sui001/switching-ceramic-extruder-controller/README.md

# ProjectAAA
Project Art! Art! Art!

read from nrf24l01 and an ardio uno. parse to another arduino to control the switching between 3 different extruders.
