sui001/switching-ceramic-extruder-controller/PCB/BOM_Board1_PCB1_2024-04-18.xlsx

No. | Quantity | Device | Designator | Footprint | Value | Manufacturer Part | Manufacturer | Supplier Part | Supplier | LCSC Price | LCSC Stock | LCSC Part Name
1 | 3 | DB128L-5.08-4P-GN-S | CN1,CN2,CN3 | CONN-TH_4P_DB128L-5.08-4P-GN-S |  | DB128L-5.08-4P-GN-S | DORABO(地博电气) | C2827883 | LCSC | 2.3268 | 2117 | 5.08mm 1x4P 排数:1 每排P数:4 直插
2 | 1 | NCD1206W1 | LED1 | LED-SMD_L3.2-W1.5-RD |  | NCD1206W1(WHITE) | 国星光电 | C130718 | LCSC | 0.273803 | 5073 | NCD1206W1
3 | 1 | NCD1206B1 | LED2 | LED1206-RD |  | NCD1206B1(BLUE) | 国星光电 | C130717 | LCSC | 0.216949 | 3757 | NCD1206B1
4 | 1 | NCD1206G1 | LED3 | LED1206-RD |  | NCD1206G1(GREEN) | 国星光电 | C99881 | LCSC | 0.195373 | 3178 | NCD1206G1
5 | 1 | NCD1206Y1 | LED4 | LED1206-RD |  | NCD1206Y1(YELLOW) | 国星光电 | C93094 | LCSC | 0.200342 | 3062 | NCD1206Y1
6 | 1 | NCD1206R1 | LED5 | LED1206-R-RD_RED |  | NCD1206R1(RED) | 国星光电 | C84270 | LCSC | 0.132452 | 18686 | NCD1206R1
7 | 1 | 2.54-1*6P母 | P1 | HDR-TH_6P-P2.54-V-F |  | Micro SD Card Reader | BOOMELE(博穆精密) | C40877 | LCSC | 0.46844 | 1217 | 间距:2.54mm 1x6P 直插
8 | 1 | 2.54-1*6P母 | P2 | HDR-TH_6P-P2.54-V-F |  | nRF24L01 | BOOMELE(博穆精密) | C40877 | LCSC | 0.46844 | 1217 | 间距:2.54mm 1x6P 直插
9 | 1 | 2.54-1*2P母 | P3 | HDR-TH_2P-P2.54-V-F |  | nRF24L01 | BOOMELE(博穆精密) | C49661 | LCSC | 0.234 | 4211 | 间距:2.54mm 1x2P 直插
10 | 5 | 1206W4F3300T5E | R1,R2,R3,R4,R5 | R1206 | 330Ω | 1206W4F3300T5E | UNI-ROYAL(厚声) | C17930 | LCSC | 0.018821 | 2186 | 330Ω ±1% 250mW 厚膜电阻
11 | 2 | 1206W4F1003T5E | R6,R7 | R1206 | 100kΩ | 1206W4F1003T5E | UNI-ROYAL(厚声) | C17900 | LCSC | 0.019788 | 6406 | 100kΩ ±1% 250mW 厚膜电阻
12 | 2 | TS-1109S-C-J | SW1,SW2 | SW-SMD_4P-L4.5-W4.5-P3.00-LS7.0 |  | TS-1109S-C-J | XKB Connectivity(中国星坤) | C318907 | LCSC | 0.209986 | 1219 | 4.5*4.5*8mm 立贴 轻触开关
13 | 3 | SS-12D10L5 | SW3,SW4,SW5 | SW-TH_SS-12D10L5 |  | SS-12D10L5 | XKB Connectivity(中国星坤) | C319012 | LCSC | 1.8981 | 8255 | 柄长5mm 直插双档 滑动开关
14 | 1 | PM254-1-04-Z-8.5_C2897367 | U3 | HDR-TH_4P-P2.54-V-F |  | OLED Display | HCTL(华灿天禄) | C2897367 | LCSC | 0.531437 | 1345 | 1x4P 间距:2.54mm 直插
15 | 1 | RK09D1130C3C | U4 | RES-TH_RK09D1130C2P | 10kΩ | RK09D1130C3C | ALPSALPINE(阿尔卑斯阿尔派) | C470316 | LCSC | 5.38 | 954 | 10kΩ ±20%
