sui001/switching-ceramic-extruder-controller/PCB/Order/jlcpcb_invoice.pdf

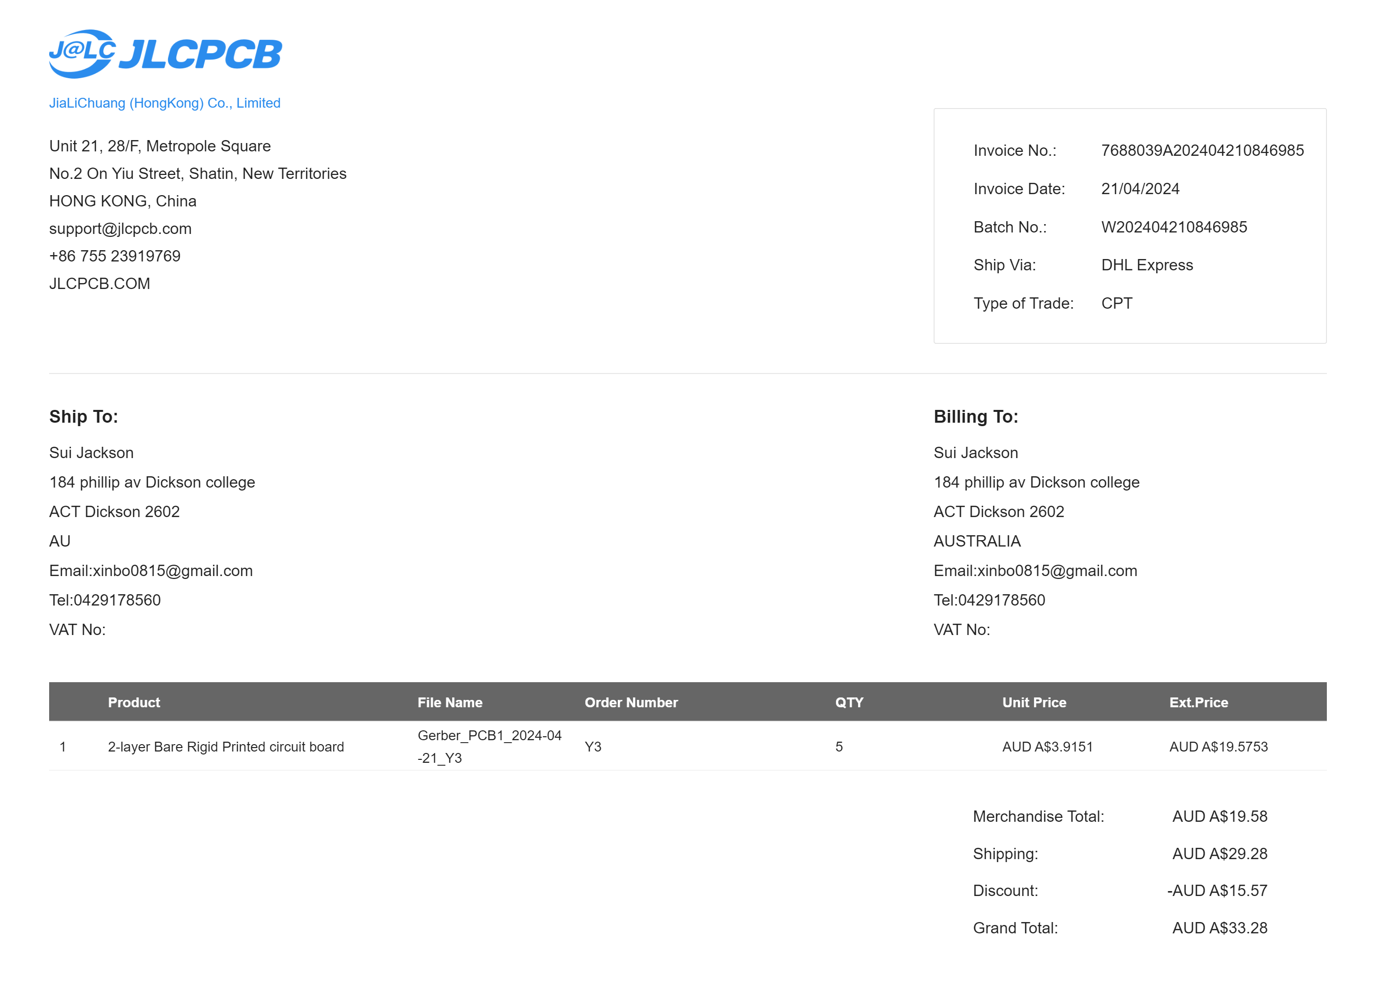
[picture p1: figure]
