sui001/switching-ceramic-extruder-controller/New Connection Map.pdf

# updated pin map for datk logging

□IE | Pinout ⑯ Antenaa | … GND

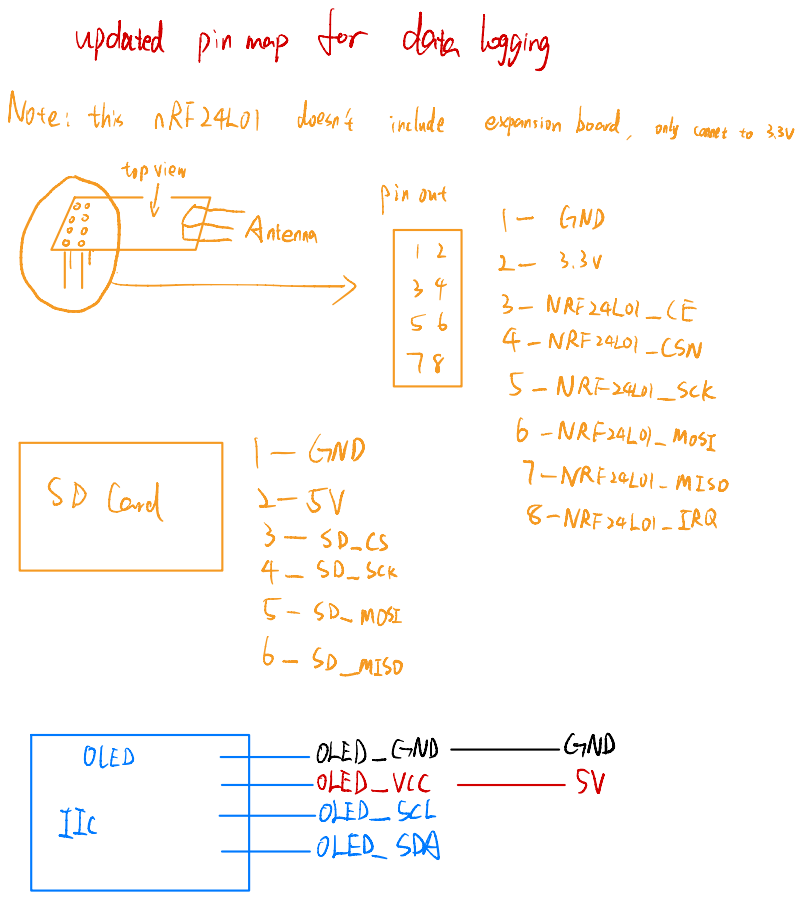
[picture p2: page 1]
Note :; this MRF 24Lol; doesnt include; expansion board ,; only connet to 3,; NRE 24L0I -; NRF 24L01 -; CSN; NRF24LO 1 -; Sck; GND; NRE24L⁰) _; MOSI; NRFEELOI _; MISO Spand; NRFZ4 LO1 -; 系RQ; SD_ MISO; OLEB; OLED -; GNB; OLED_; VCC; SCL; OLEB-; SDA

## Arduino® UNO R4 WiFi

# Mechanical Information

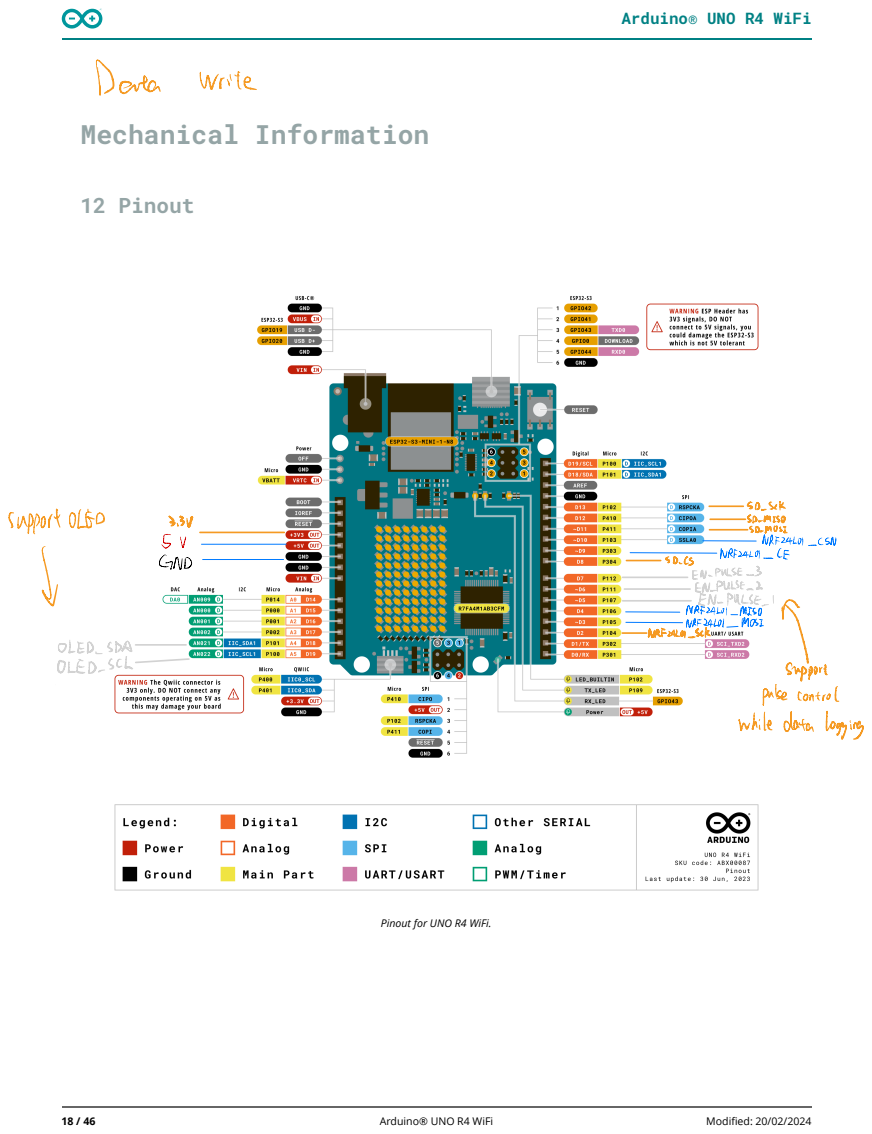
[picture p3: page 2]
Arduino® UNO R4 WiFi; Modified: 20/02/2024; 12 Pinout; Devla write; Sck; M号O; SUpPort OLED; SDIMOSI; NRF 24LO1 -; CSN; GND; ARFI4LO1 -; BULSE -; PULSE-; BULSE_; NREE4Lol; mIso; NRE24LO1 -; sck; OLED、; SBA; RRFI4LOl; MOSI; OLED-; SCh; support

Bulse control
while data logging

Pinout for UNO R4 WiFi.

## Arduino® UNO R4 WiFi

# Mechanical Information

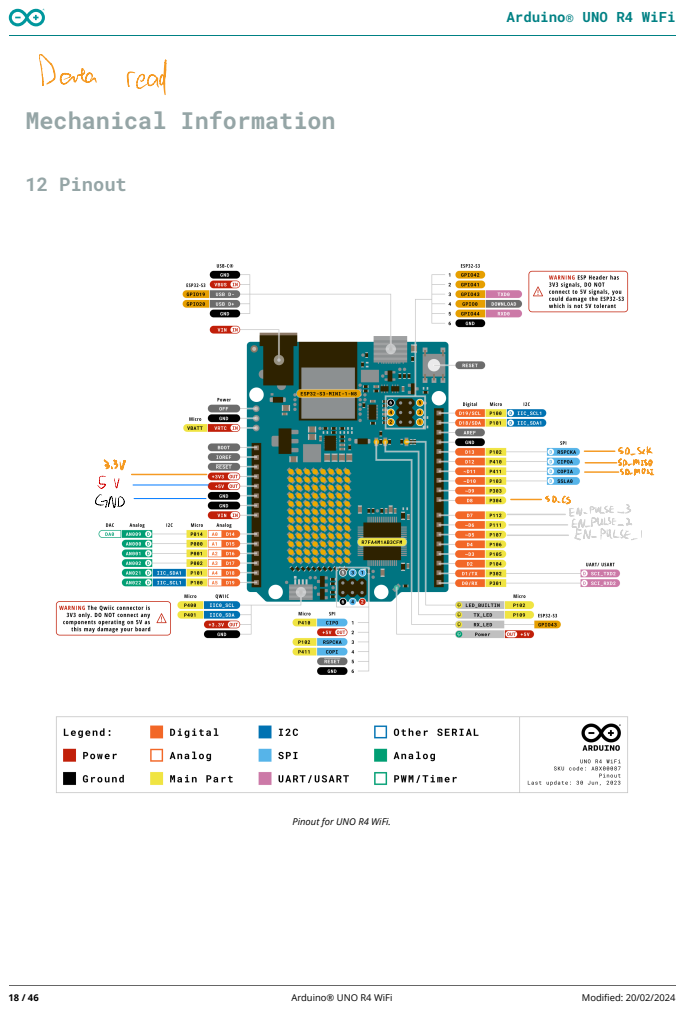
[picture p4: page 3]
Arduino® UNO R4 WiFi; Modified: 20/02/2024; 12 Pinout; Deala read; Sck; M号O; SBMOsI; GND; BULSE -; PULSE-; BULSE_

Pinout for UNO R4 WiFi.

updated | pin map for | palse | override
!m

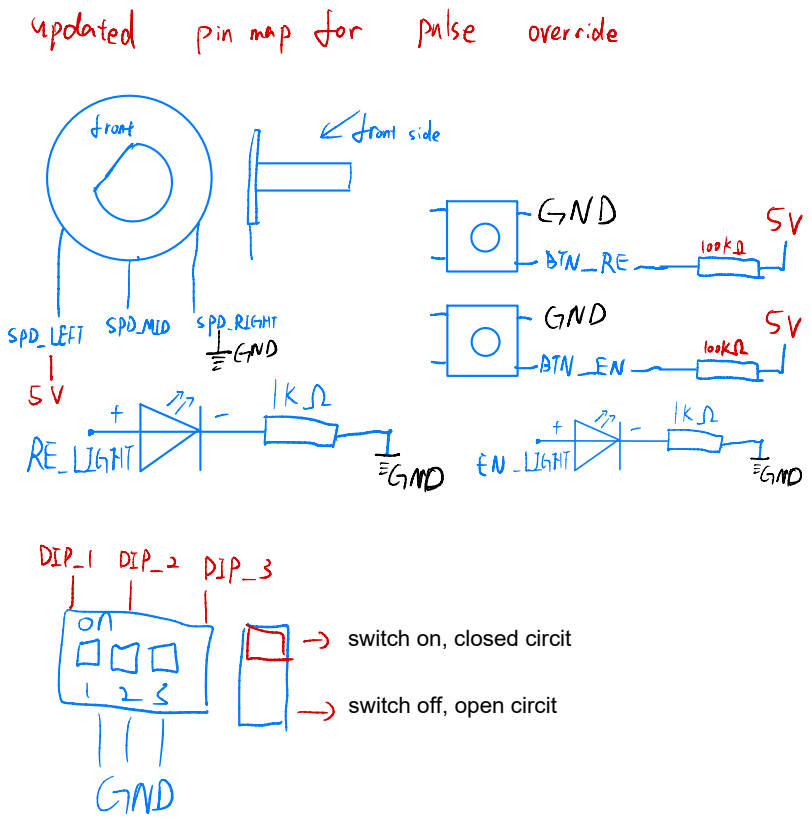
[picture p5: page 4]
GNDTOIMF; sookr 一; BTN_; SPD.; LEFT SBB-; MIB; SPB-; RIGHT; GND TO.uF 一; 言GND; BTN _; LIGHT; LIGET; 营Gx; DIP-; DIP_; PIP-; 四敏OO; switch on, closed circit

switch off, open circit

# Step motor driver control

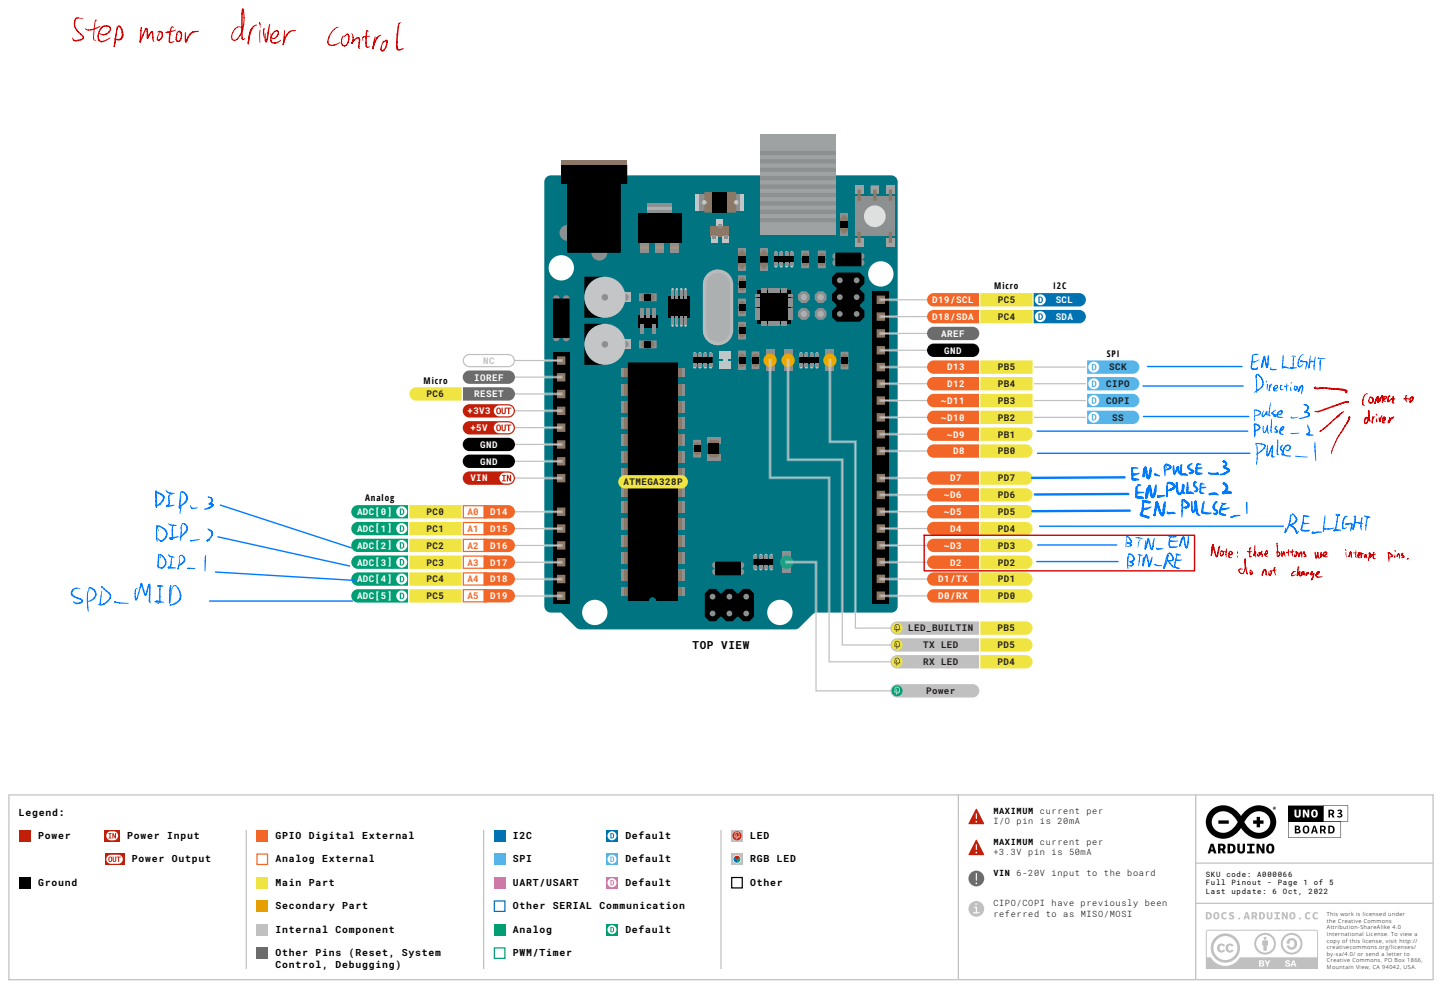
[picture p6: page 5]

PC2 | A2
PC3 | A3

MAXIMUM current per I/O pin is 20mA MAXIMUM current per +3.3V pin is 50mA VIN 6-20V input to the board CIPO/COPI have previously been referred to as MISO/MOSI

GPIO Digital External
Analog External
Main Part
Secondary Part
Internal Component
Other Pins (Reset, System
Control, Debugging)

SKU code: A000066 Full Pinout - Page 1 of 5 Last update: 6 Oct, 2022

This work is licensed under the Creative Commons Attribution-ShareAlike 4.0 International License. To view a

copy of this license, visit http://creativecommons.org/licenses/by-sa/4.0/ or send a letter to Creative Commons, PO Box 1866, Mountain View, CA 94042, USA.

## use case 1 :

µµ、

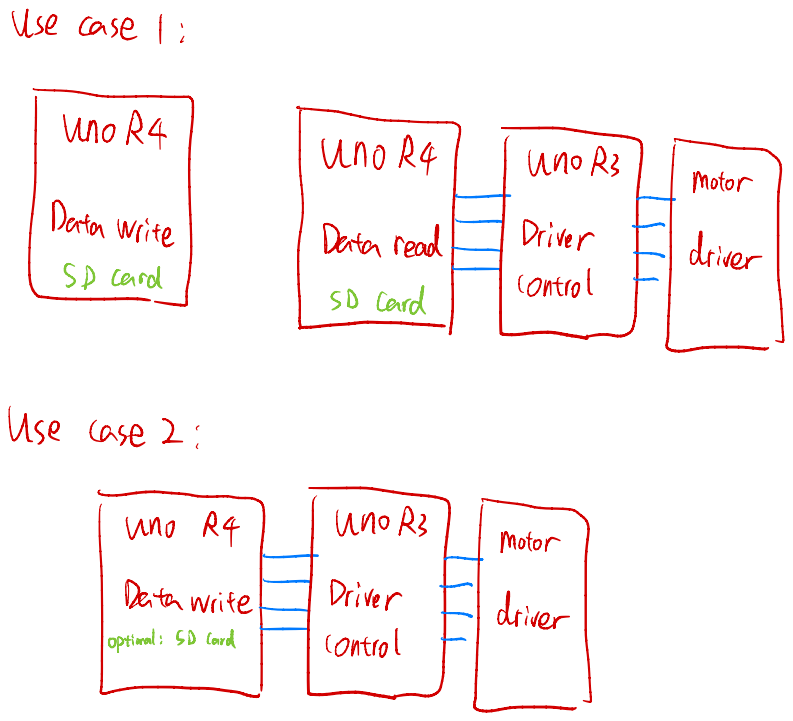
[picture p7: page 6]
Use case 2 : µµ
