sui001/switching-ceramic-extruder-controller/PCB/PCB_PCB1_2024-04-18.pdf

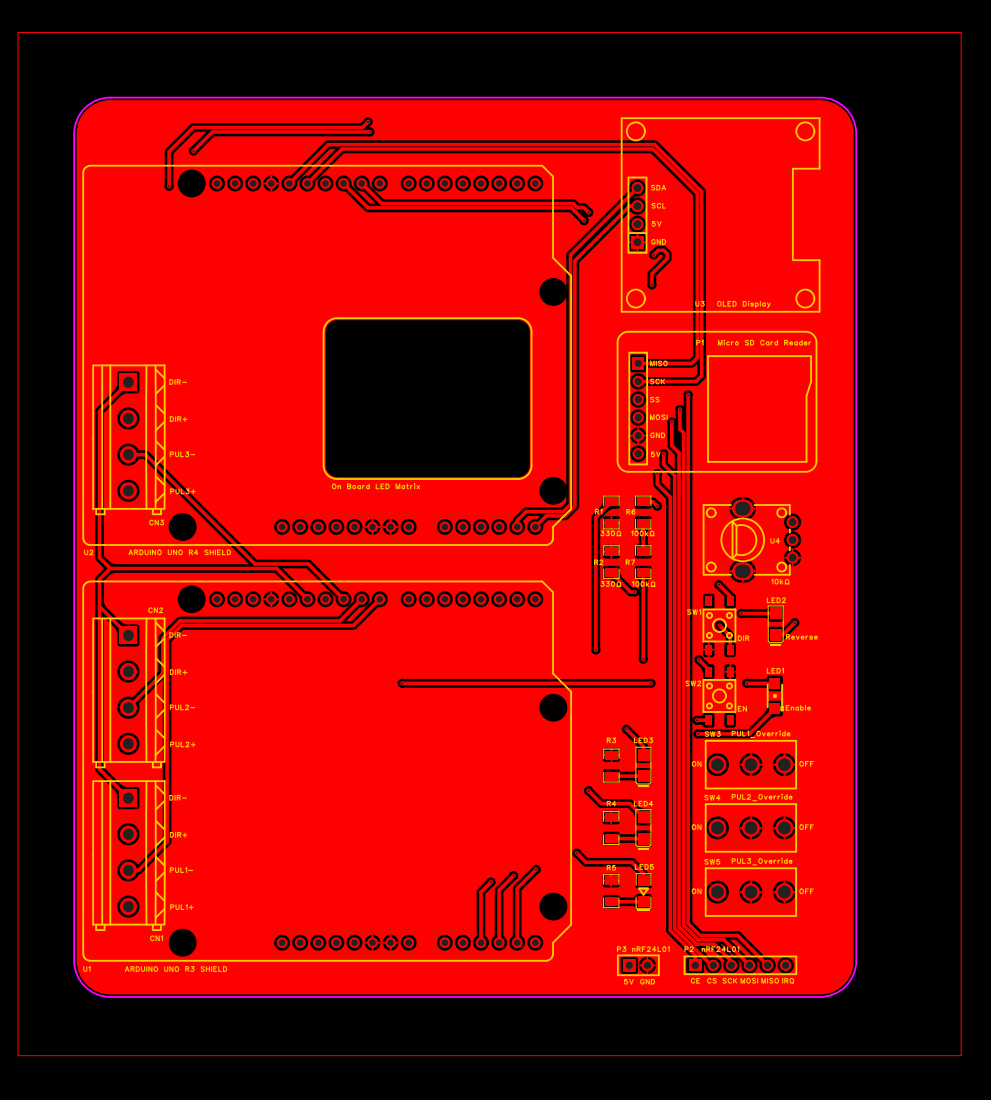
[picture p8: page 1]

On Board LED Matrix

5VGND CECSSCKMOSIMSOIRQ U1 ARDUINO UNO R3 SHIELD

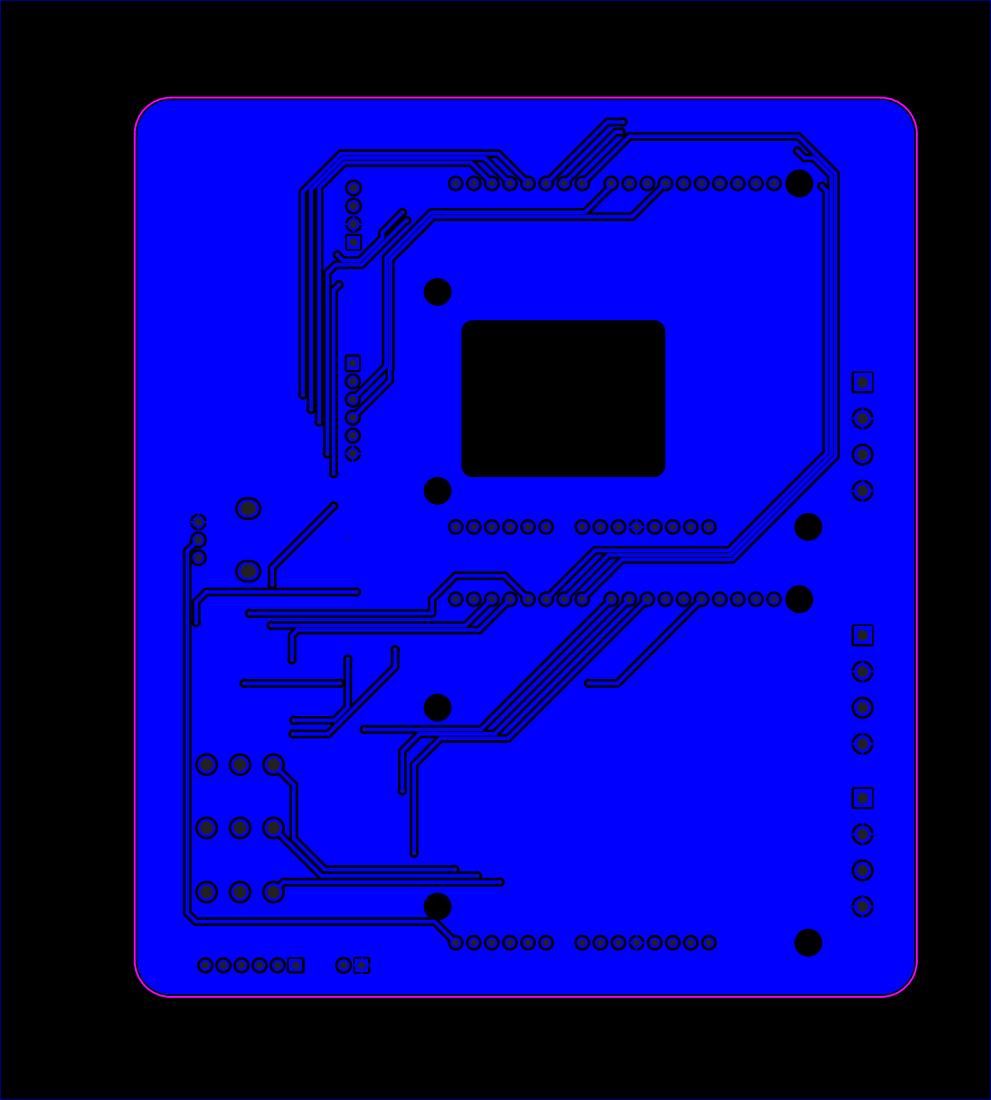
[picture p9: page 2]

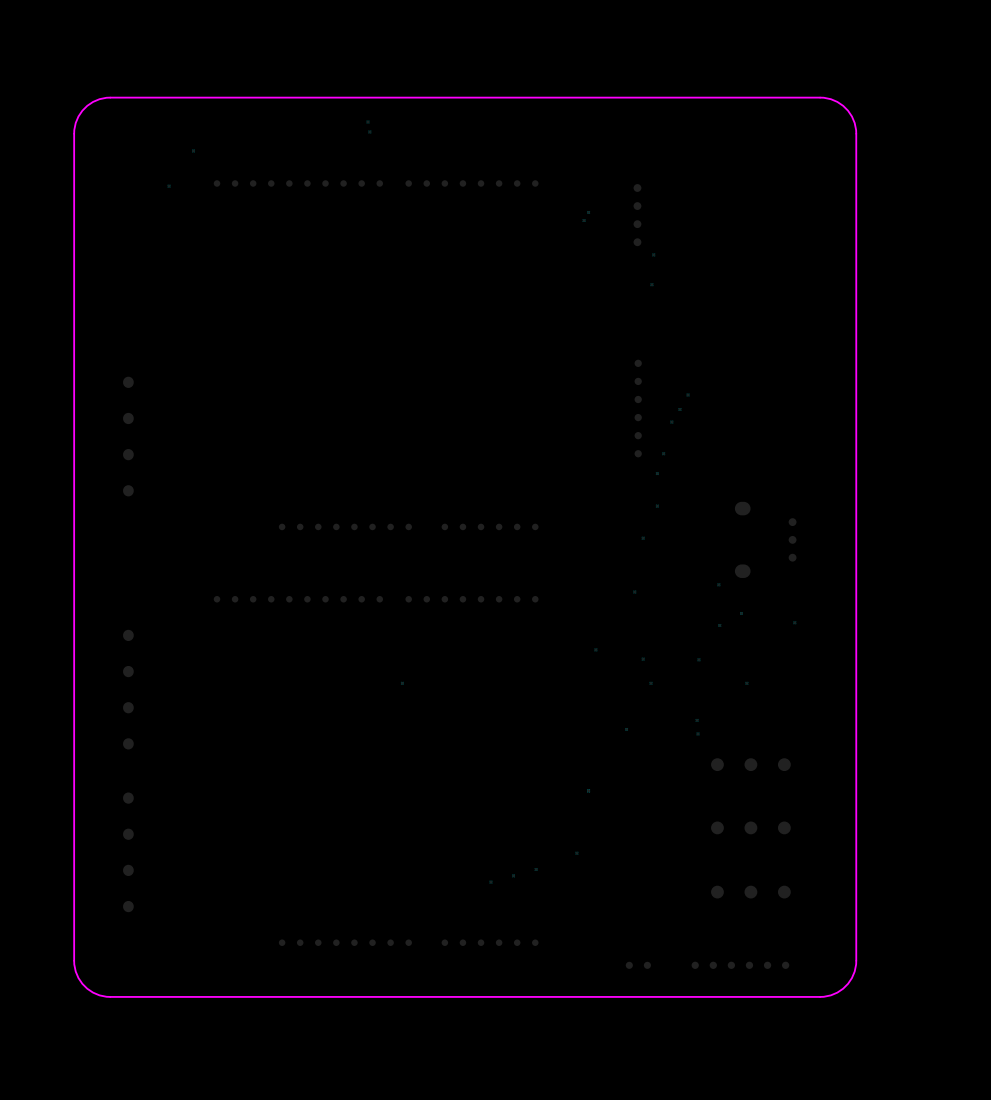
[picture p10: page 3]
