sui001/switching-ceramic-extruder-controller/PCB/SCH_Schematic1_2024-04-18.pdf

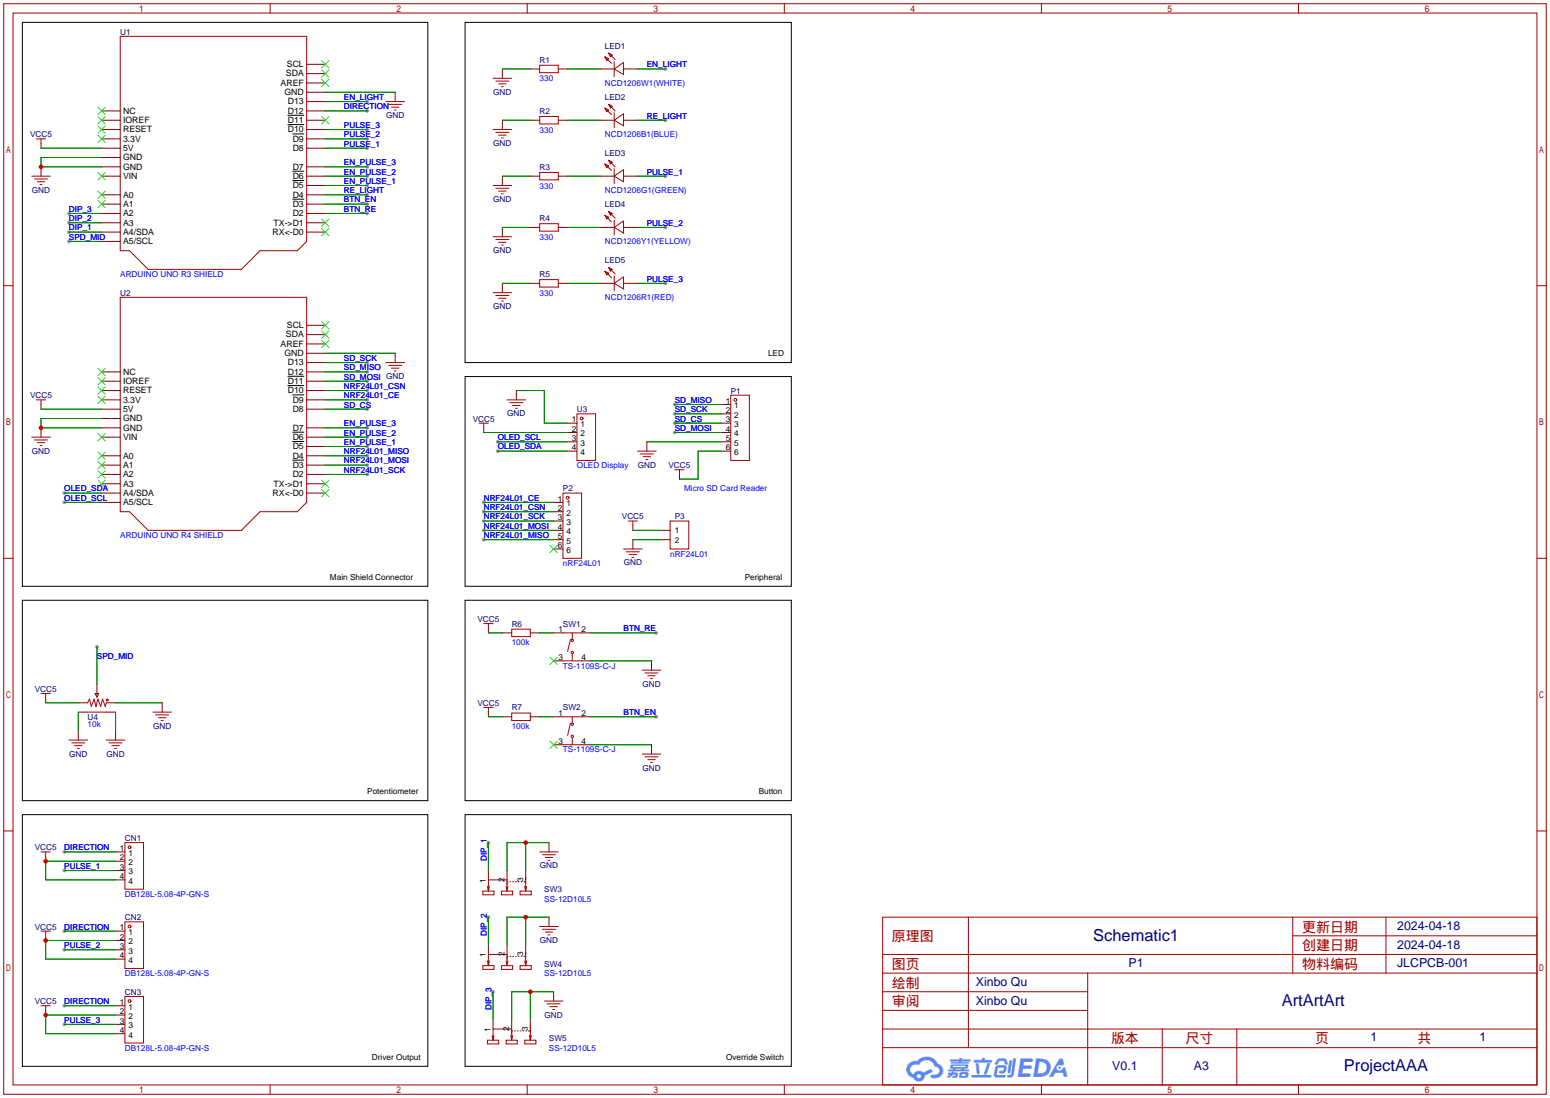
[picture p11: page 1]

Micro SD Card Reader
