sui001/switching-ceramic-extruder-controller/PCB/Order/lcsc.pdf

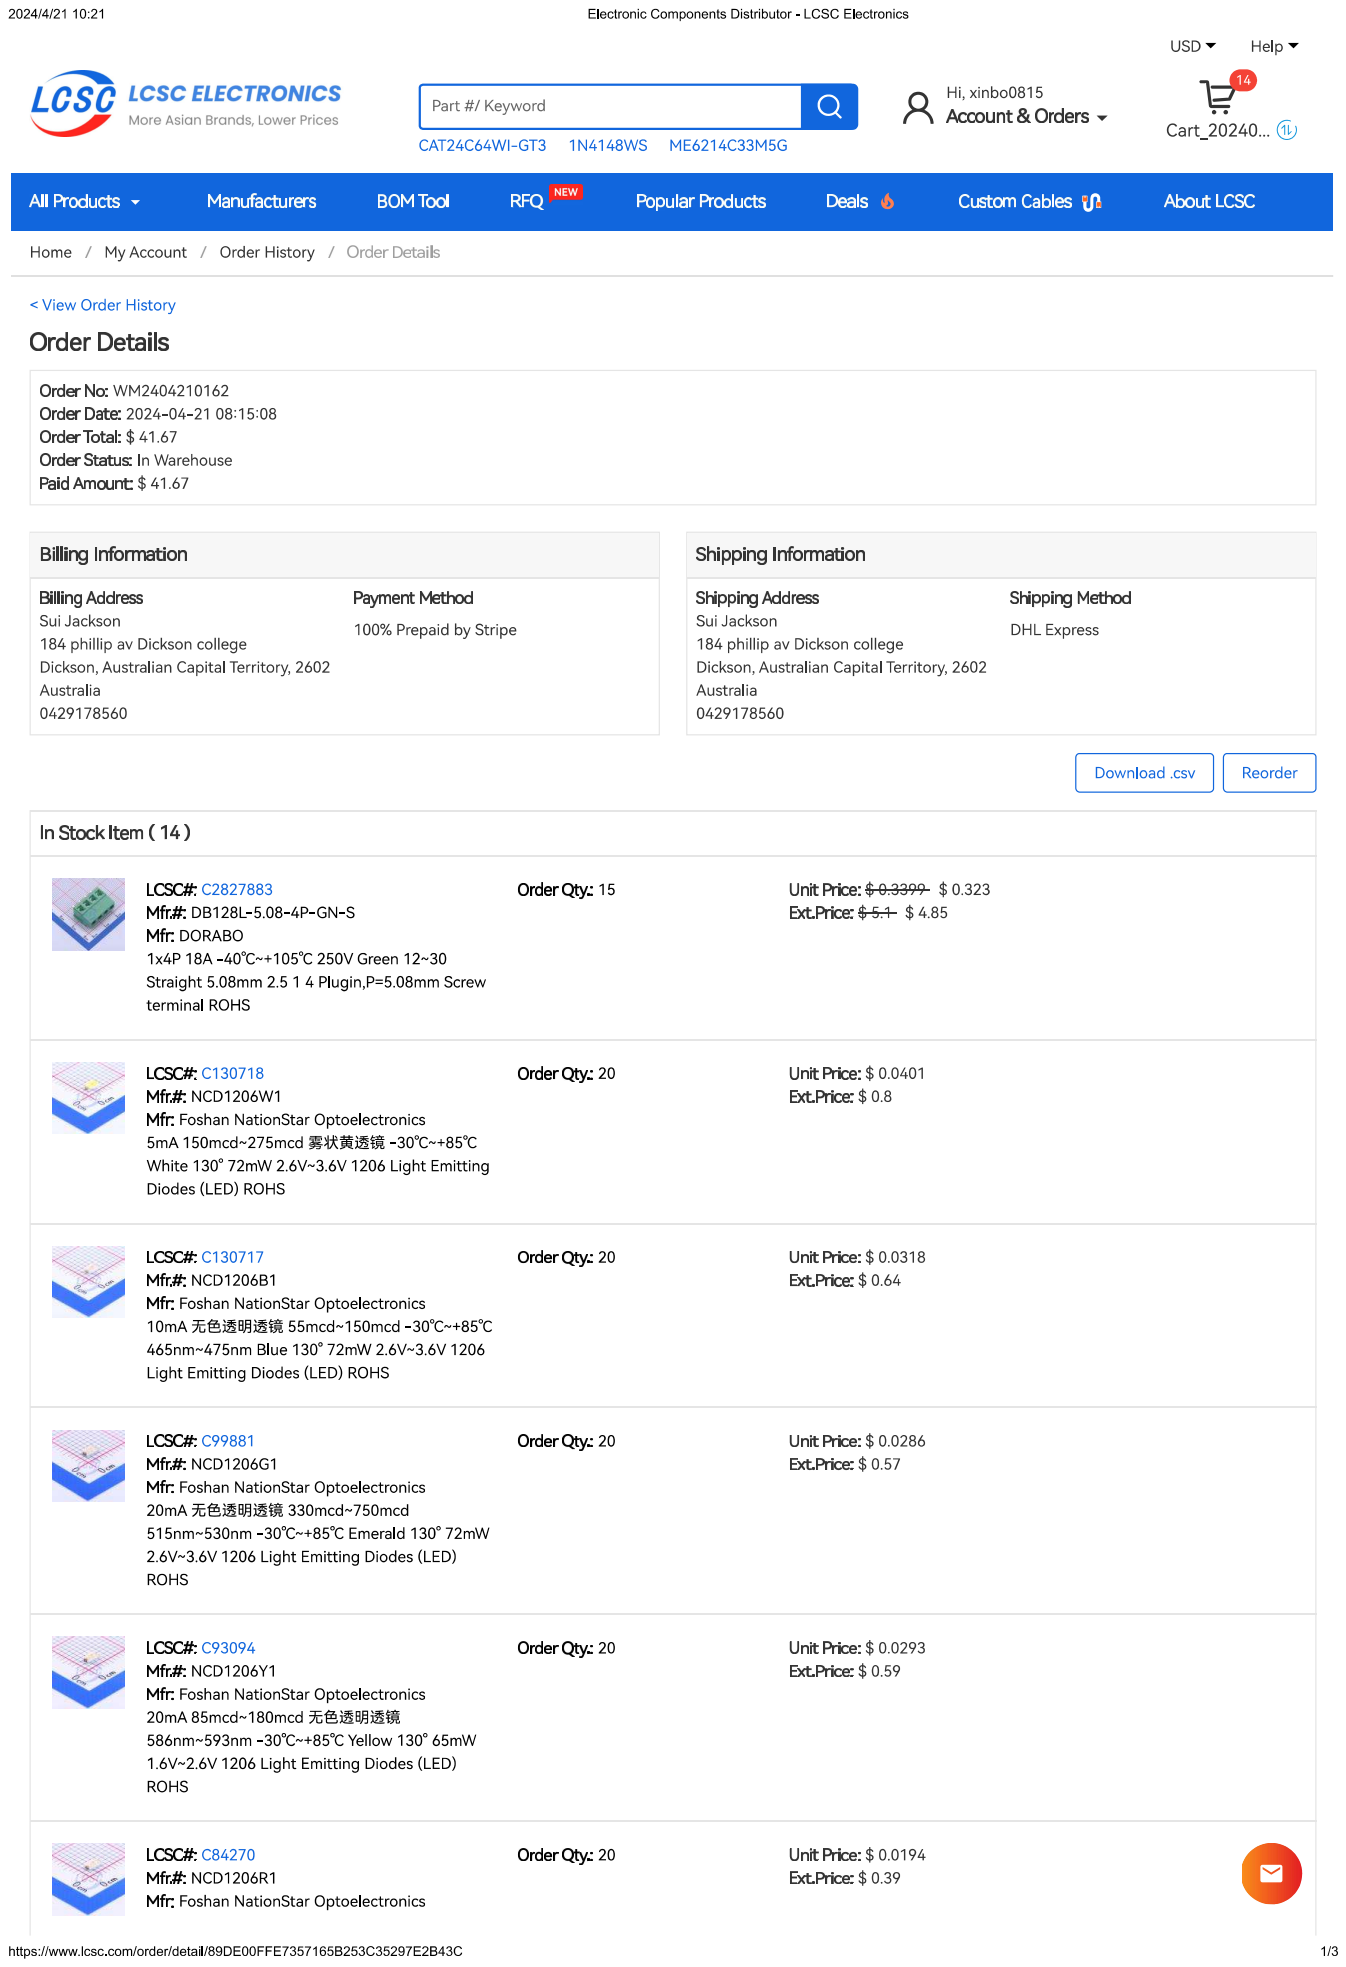
[picture p12: page 1]

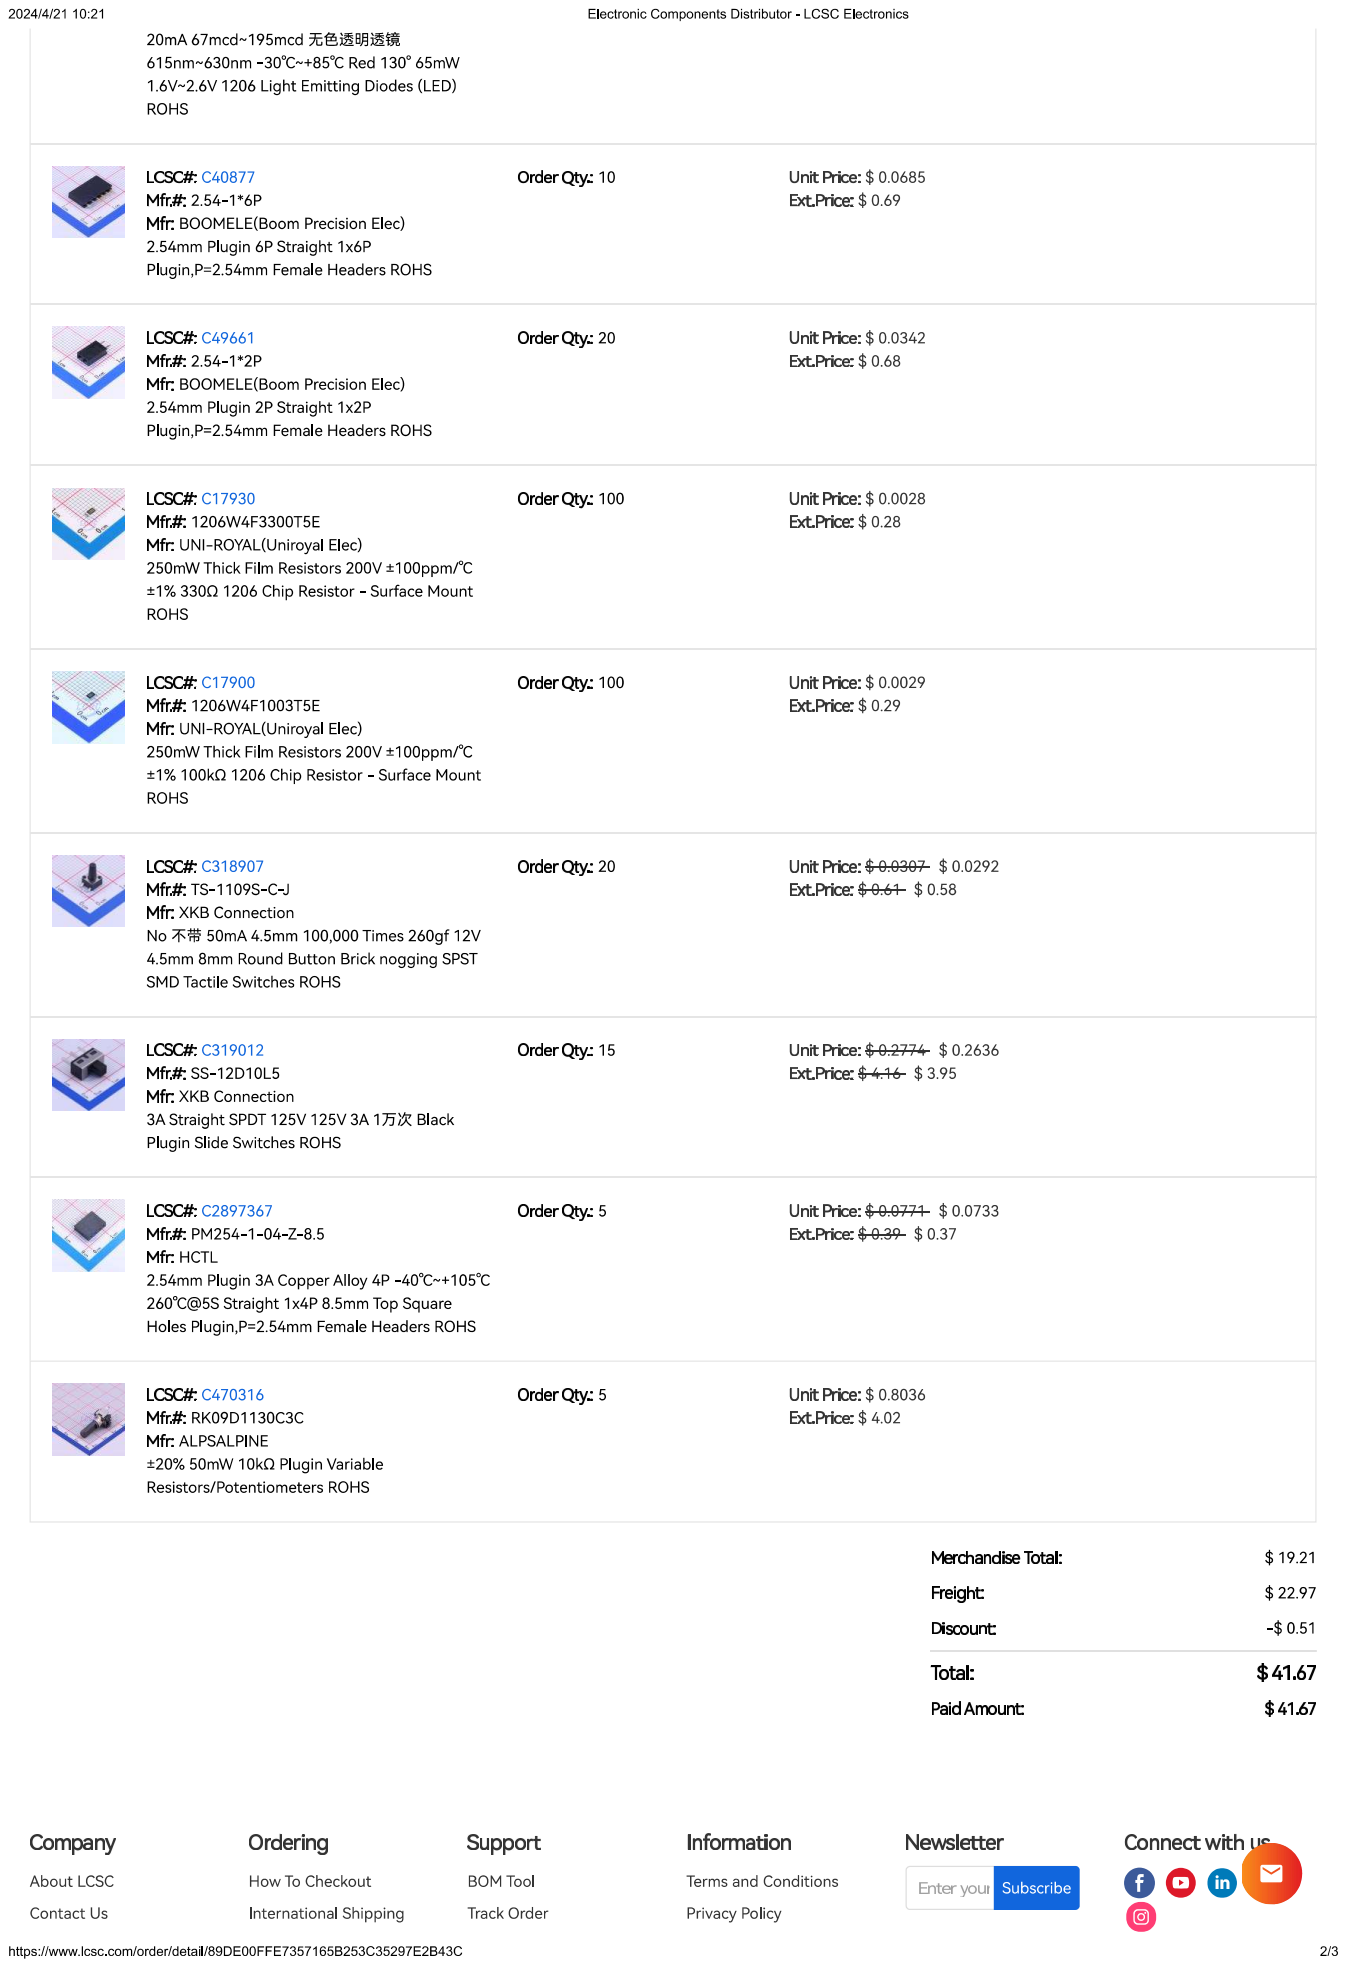
[picture p13: page 2]

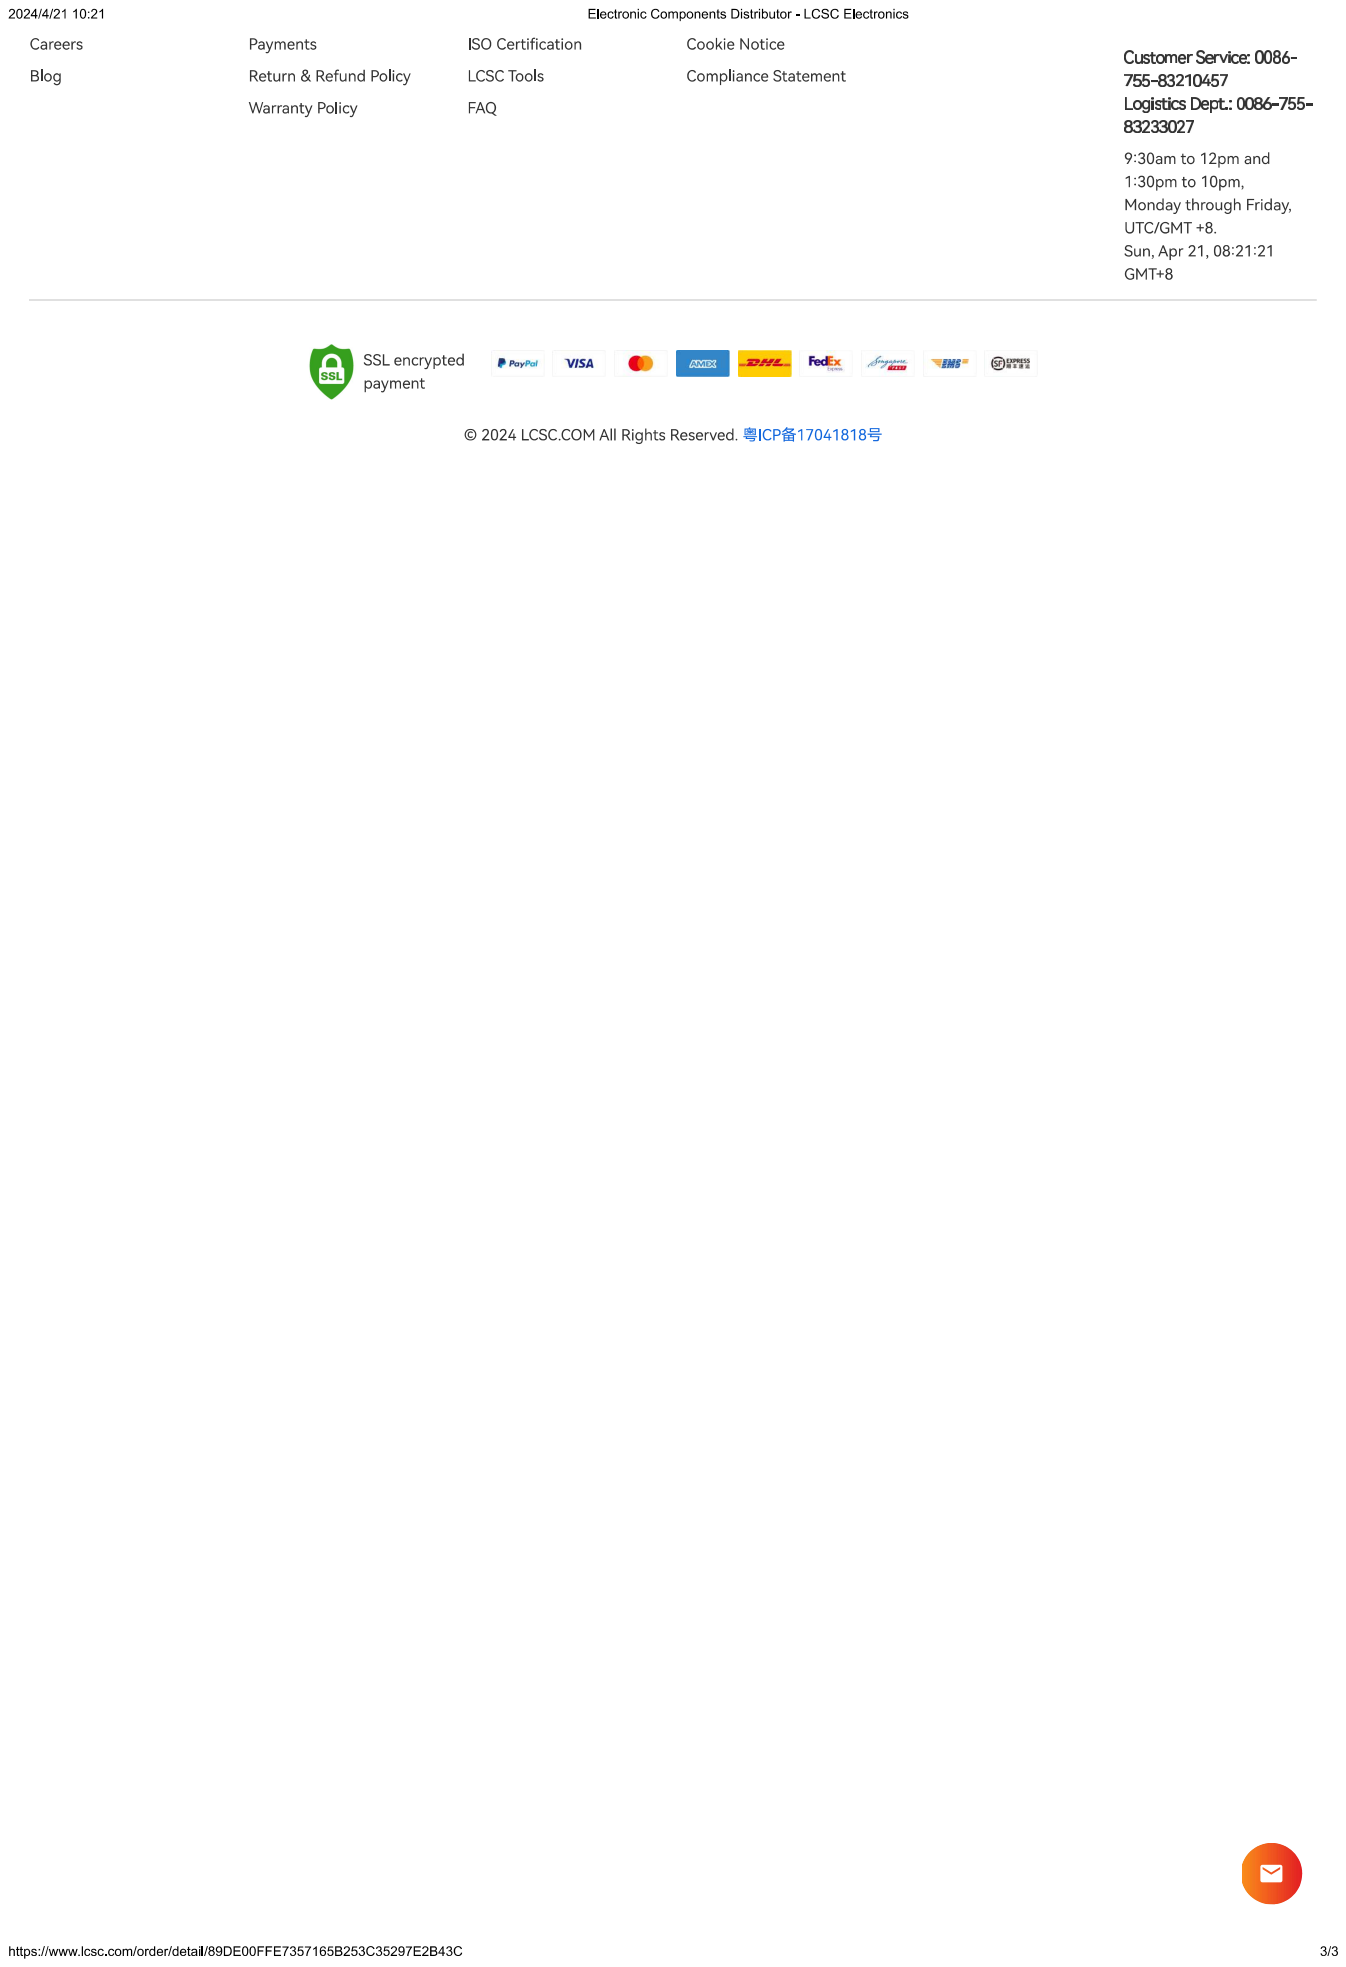
[picture p14: page 3]
