sui001/switching-ceramic-extruder-controller/(commit log)

2024-03-17 update data logging feature and the pin mapping
2024-03-19 update data logging/reading feature & some led matrix display
2024-03-20 update new pin out diagram
2024-03-25 update software debouncer for buttons
2024-04-18 update PCB layout, BOM and Gerber files
    [BOM_Board1_PCB1_2024-04-18.xlsx]
2024-04-21 update labels of PCB
